Ralph4711/Arduino-Esp32-Wroom-Open3DScanner/Original Firmware Nazzrim/readme.md

Original version of the Nazzrim Firmware without any changes.

Many mistakes and can not compile anymore in Arduino IDE
