Ralph4711/Arduino-Esp32-Wroom-Open3DScanner/New Firmware for New PCB/Compiled HEX/readme.md

## Ready for use Compiled HEX File

Here is a version of the Firmware that is already compiled and just needs to be uploaded to the ESP32.

Anyone can find out how to do this with a little search on the Internet.

That's why Google was invented, among other things!
