Ralph4711/Arduino-Esp32-Wroom-Open3DScanner/PCB NEW V2/BOM_3D Scanner_3D Scanner_2025-02-09.xlsx

No. | Quantity | Comment | Designator | Footprint | Value | Manufacturer Part | Manufacturer | Supplier Part | Supplier
1 | 1 | AZDelivery-ESP32_NodeMCU | A1 | Nazrim:AZDelivery-ESP32_NodeMCU | AZDelivery-ESP32_NodeMCU
2 | 1 | A4988 Driver | A2TT1 | Nazrim:A4988 | Pololu_Breakout_A4988
3 | 1 | A4988 Driver | A3RT1 | Nazrim:A4988 | Pololu_Breakout_A4988
4 | 1 | 10μ | C1 | Capacitor_THT:CP_Radial_D4.0mm_P2.00mm
5 | 3 | 100μ | C2,C4,C5 | Capacitor_THT:CP_Radial_D6.3mm_P2.50mm
6 | 1 | 473n | C3 | Capacitor_THT:C_Disc_D3.4mm_W2.1mm_P2.50mm
7 | 1 | LED_Dual_AAC | D1 | Connector_PinHeader_2.54mm:PinHeader_1x03_P2.54mm_Vertical
8 | 4 | LED_Series | D2,D3,D4,D5 | Nazrim:TerminalBlock_2_P5.08mm
9 | 1 | Nokia5110-Display | DS1 | Connector_PinHeader_2.54mm:PinHeader_1x08_P2.54mm_Vertical | Nokia5110-Display
10 | 2 | CAM_Extern | Extern-CAM,RESET | Connector_PinHeader_2.54mm:PinHeader_1x03_P2.54mm_Vertical
11 | 1 | 12V Power In | J1 | Nazrim:TerminalBlock_2_P5.08mm
12 | 1 | Screw_Terminal_01x02 | J2 | Nazrim:TerminalBlock_2_P5.08mm
13 | 2 | Stepper_Motor_bipolar | M1RT1,M2TT1 | Connector_PinHeader_2.54mm:PinHeader_1x04_P2.54mm_Vertical
14 | 4 | M3 | M3,M3,M3,M3 | MountingHole:MountingHole_3.2mm_M3
15 | 1 | IRLB8721PBF | Q1 | Nazrim:TO-220-3_Vertical_Cooler | LT1086CT-5
16 | 3 | 100 | R1,R2,R6 | Resistor_THT:R_Axial_DIN0207_L6.3mm_D2.5mm_P10.16mm_Horizontal
17 | 1 | 10k | R3 | Resistor_THT:R_Axial_DIN0207_L6.3mm_D2.5mm_P10.16mm_Horizontal
18 | 1 | 330 | R4 | Resistor_THT:R_Axial_DIN0207_L6.3mm_D2.5mm_P10.16mm_Horizontal
19 | 1 | 10k | R5 | Resistor_THT:R_Axial_DIN0207_L6.3mm_D2.5mm_P10.16mm_Horizontal
20 | 1 | 220 | R7 | Resistor_THT:R_Axial_DIN0207_L6.3mm_D2.5mm_P10.16mm_Horizontal
21 | 1 | Rotary_Encoder_Switch | SW1 | Nazrim:Rotary_Encoder_Switch
22 | 1 | 12V Power Switch | SW2 | Nazrim:TerminalBlock_2_P5.08mm
23 | 1 | LT1086CT-5 | U2 | Nazrim:TO-220-3_Vertical_Cooler
24 | 1 | PC817X3NSZ9F | U4 Opt. | DIP-4_L4.6-W6.5-P2.54-LS7.6-BL |  | PC817X3NSZ9F | SHARP(夏普) | C96006 | LCSC
