Ralph4711/Arduino-Esp32-Wroom-Open3DScanner/(commit log)

2025-02-08 Create NEW PCB V2
2025-02-08 Rename 3D_3D Scanner_2025-02-08.png to PCB.png
2025-02-08 Gerber Files of new PCB V2.0a with extern camera
